craigyjp/Akai-AX80-Display-2.52-inch/Photos/20250727_185641.jpg

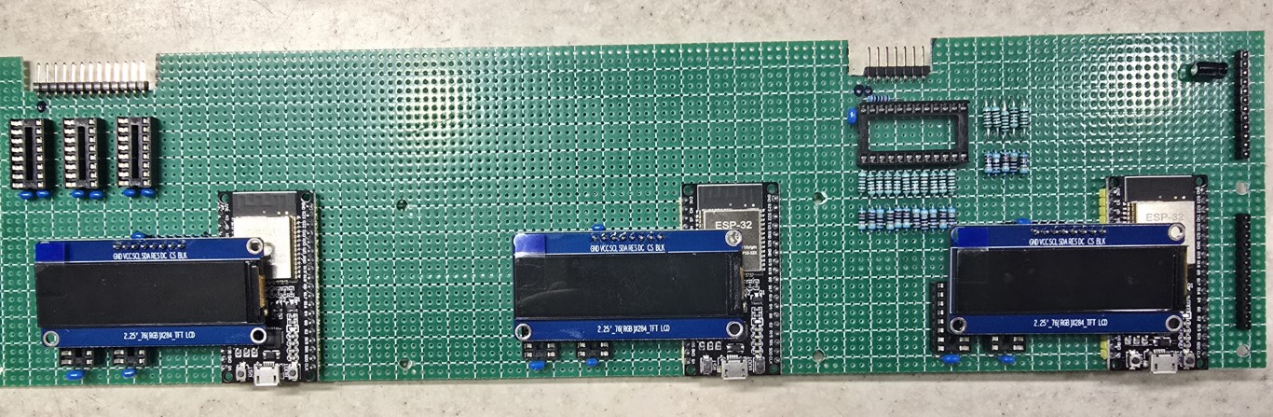
Photos/20250727_185641.jpg
