craigyjp/Akai-AX80-Display-2.52-inch/Photos/20250727_185739.jpg

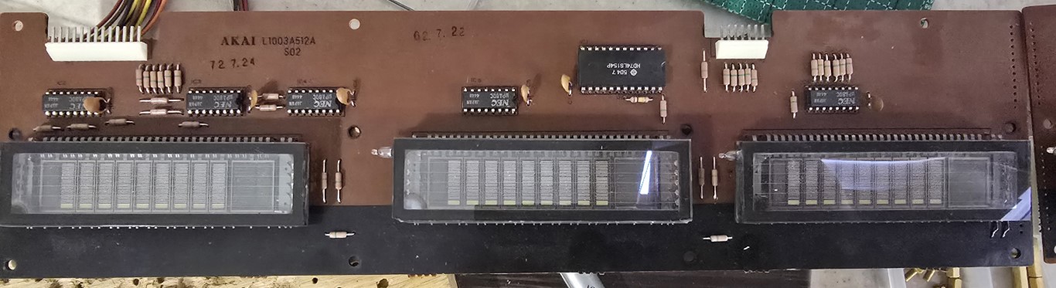
Photos/20250727_185739.jpg
