craigyjp/Akai-AX80-Display-2.52-inch/Photos/20250729_184621.jpg

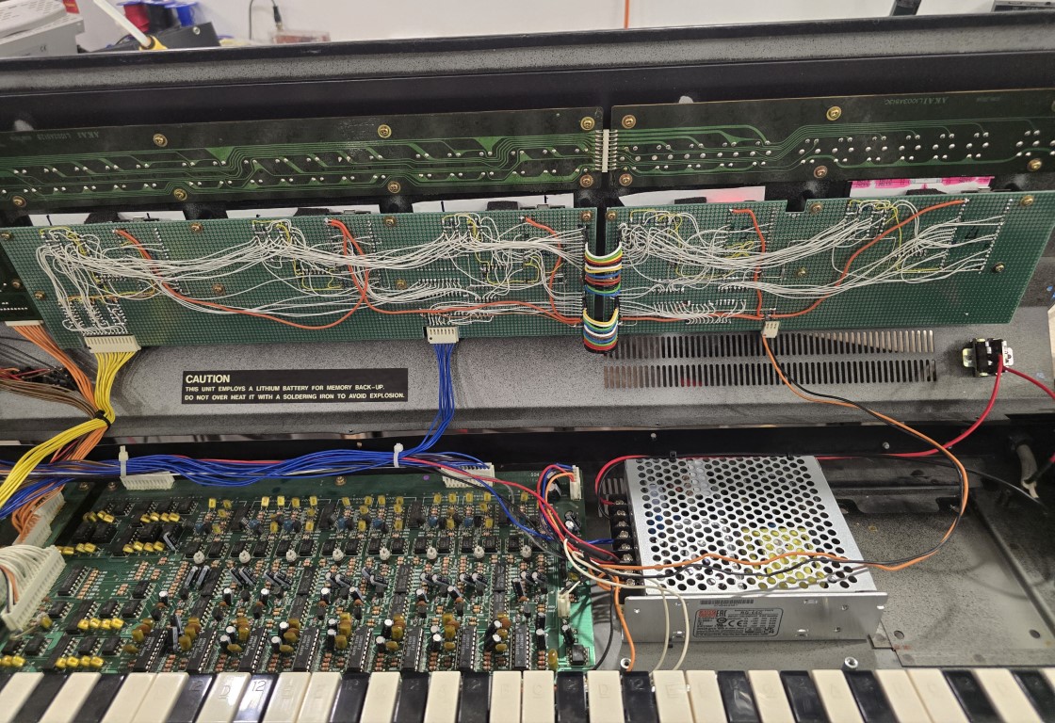
Photos/20250729_184621.jpg
