craigyjp/Akai-AX80-Display-2.52-inch/Interface1.pdf

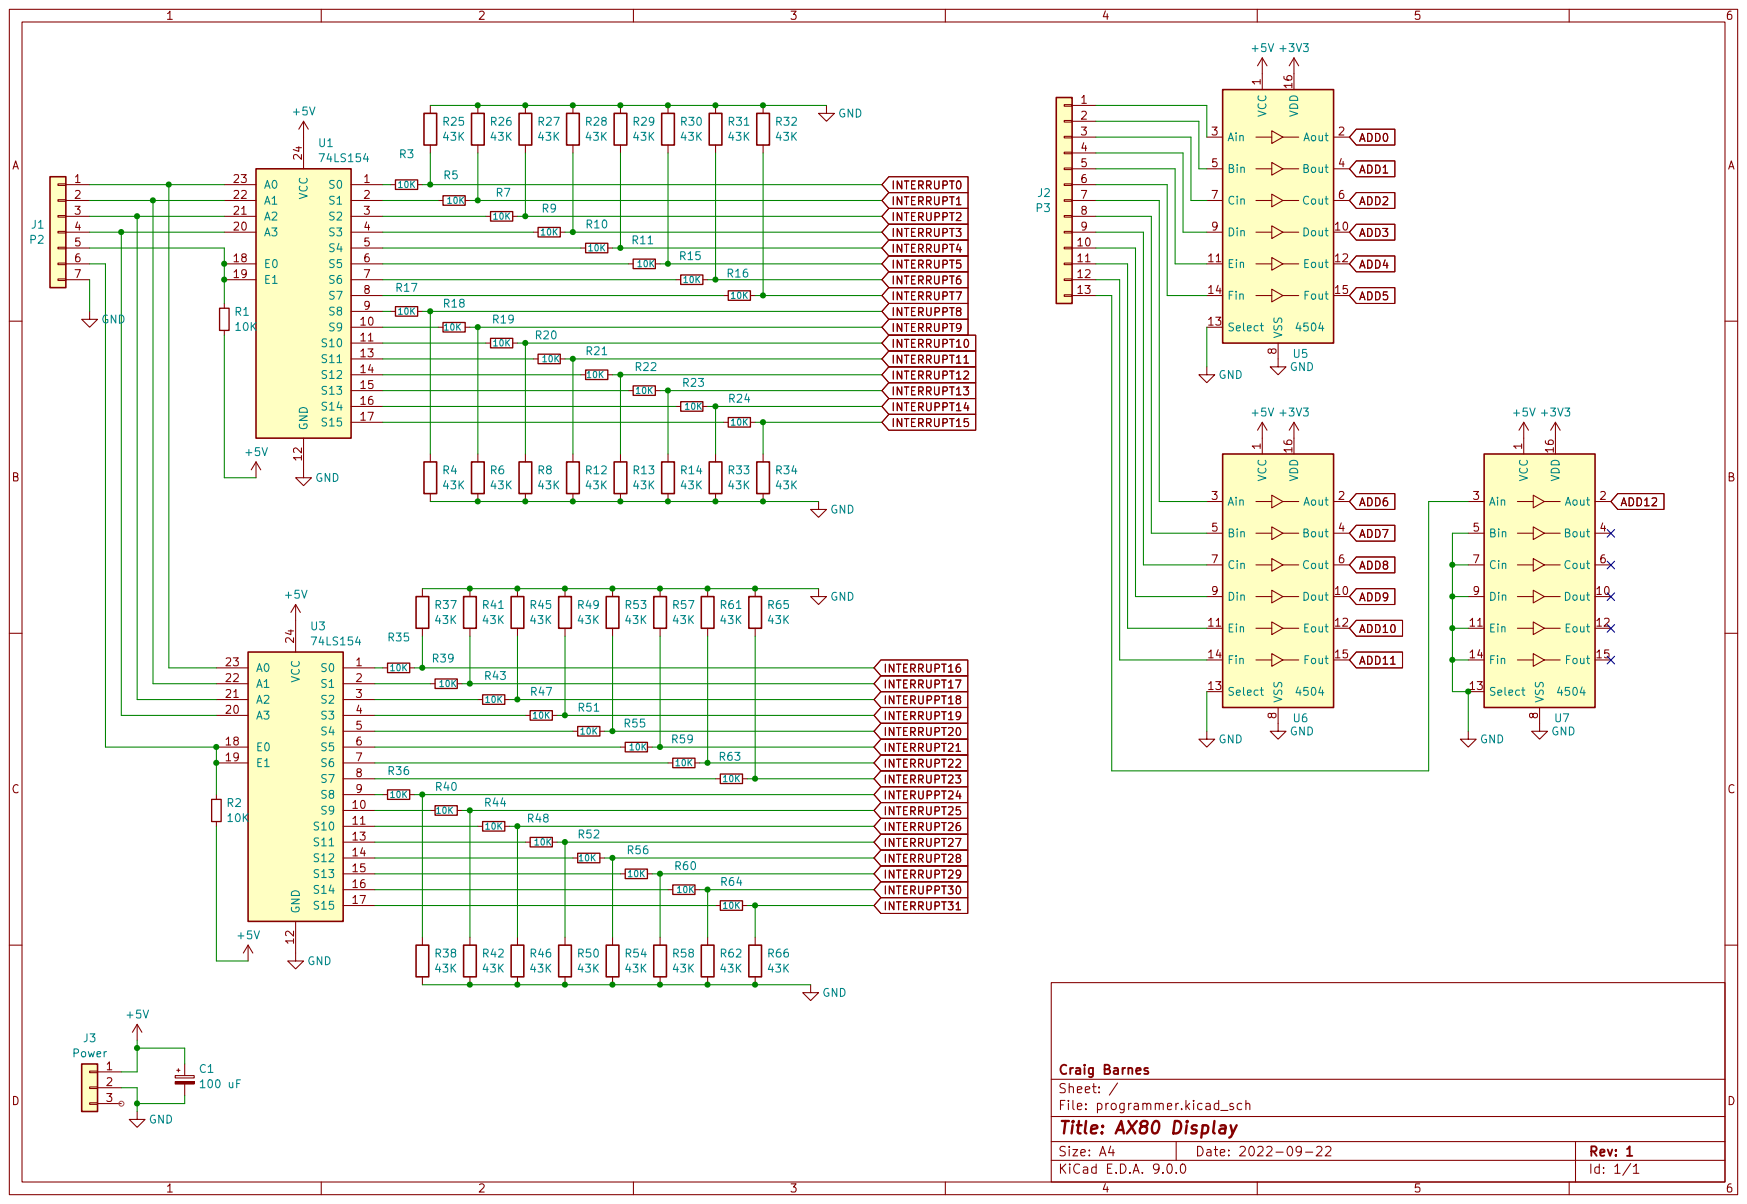
[picture p5: page 1]
