craigyjp/Akai-AX80-Display-2.52-inch/Interface2.pdf

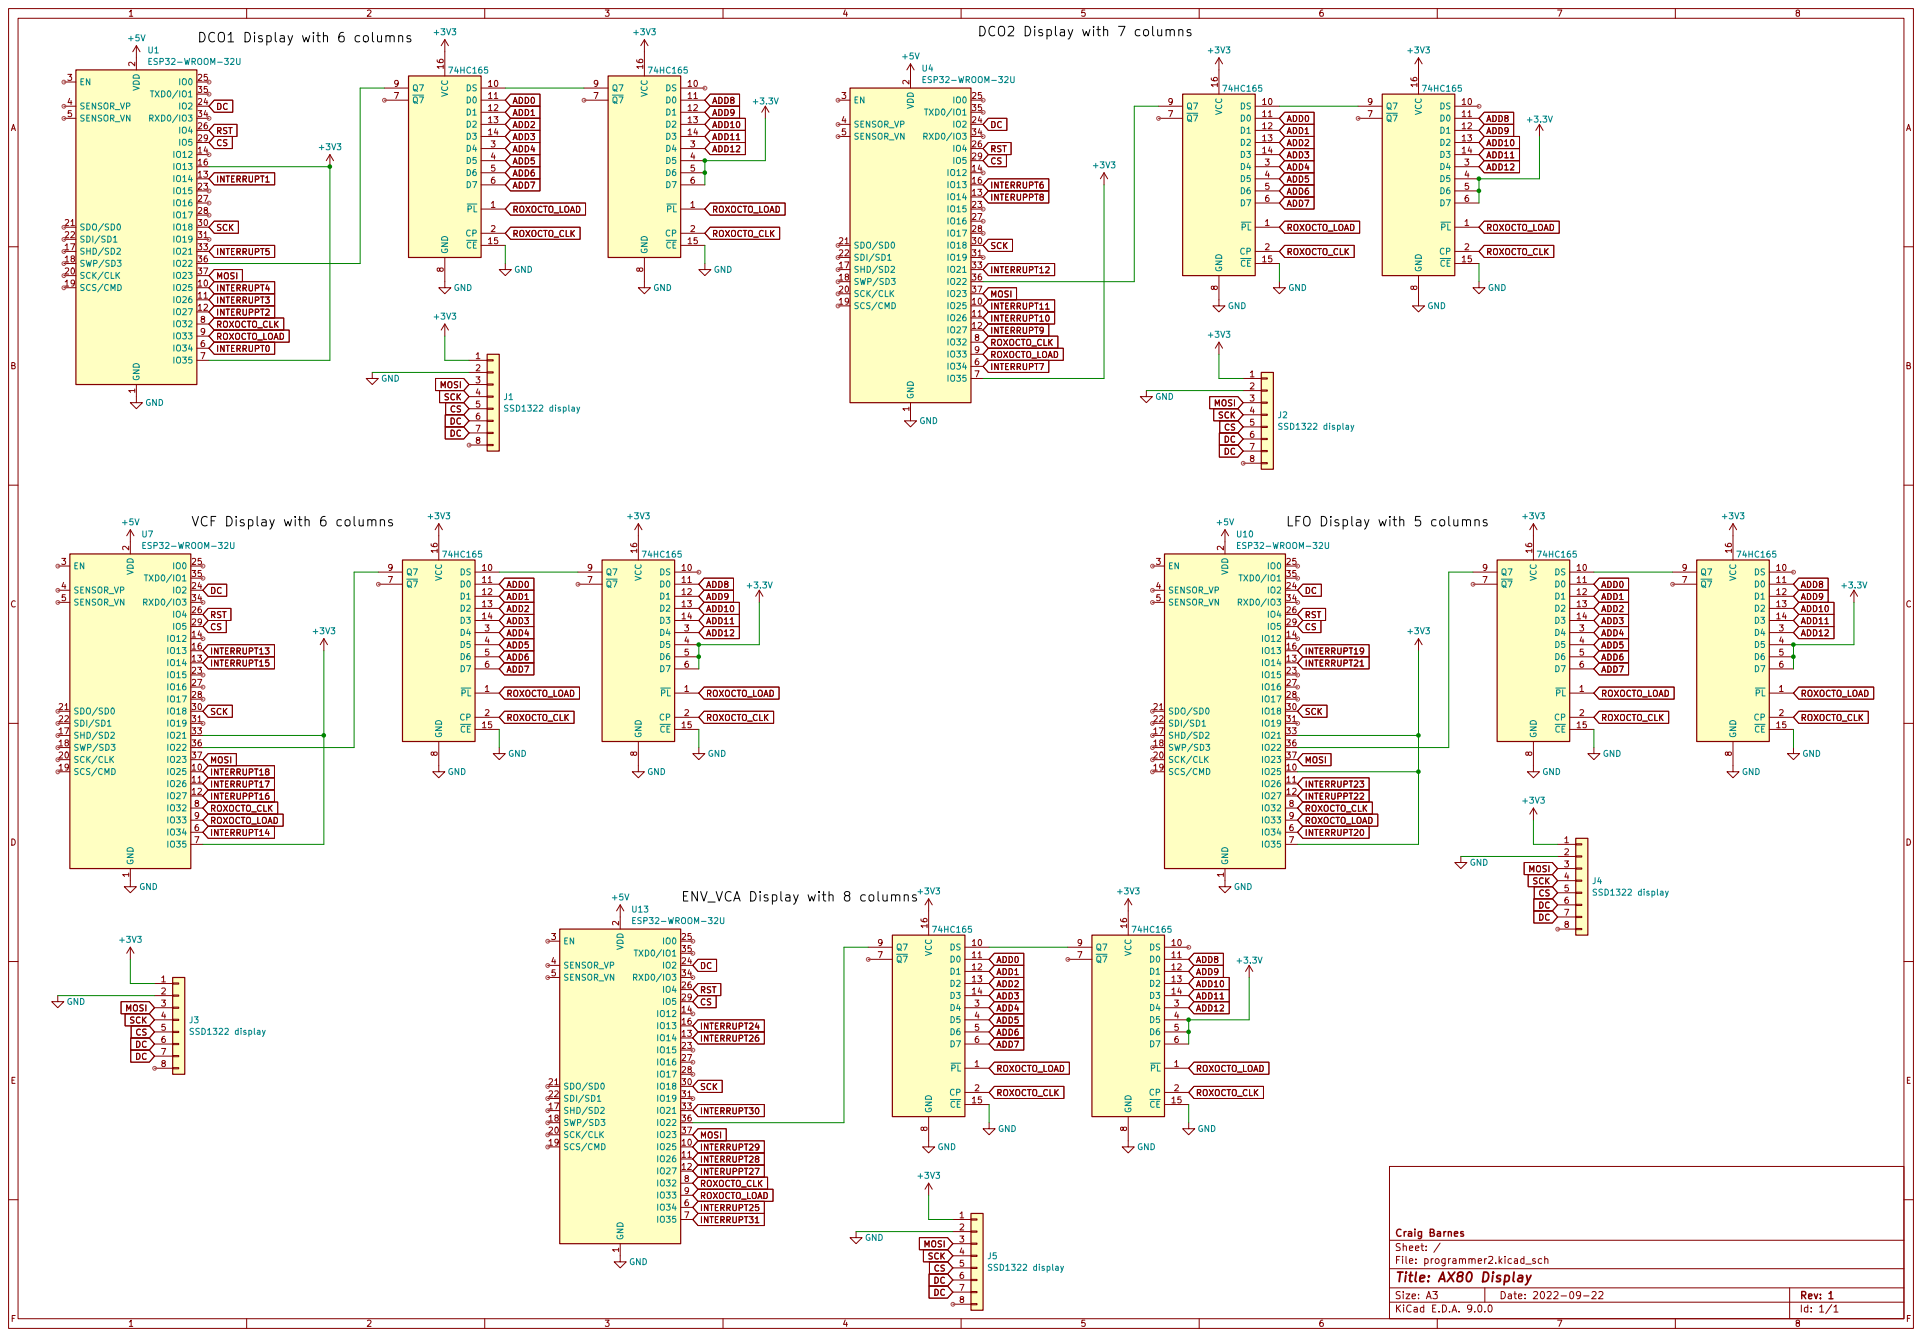
[picture p6: page 1]
